apardyl/slam-robot/README.md

# slam-robot
Software and Hardware for Kinect v2 and Odroid XU4 based mobile platform.
