apardyl/slam-robot/Hardware/Mainboard/main.brd

## EAGLE design Hardware/Mainboard/main.brd (2016-07-07)

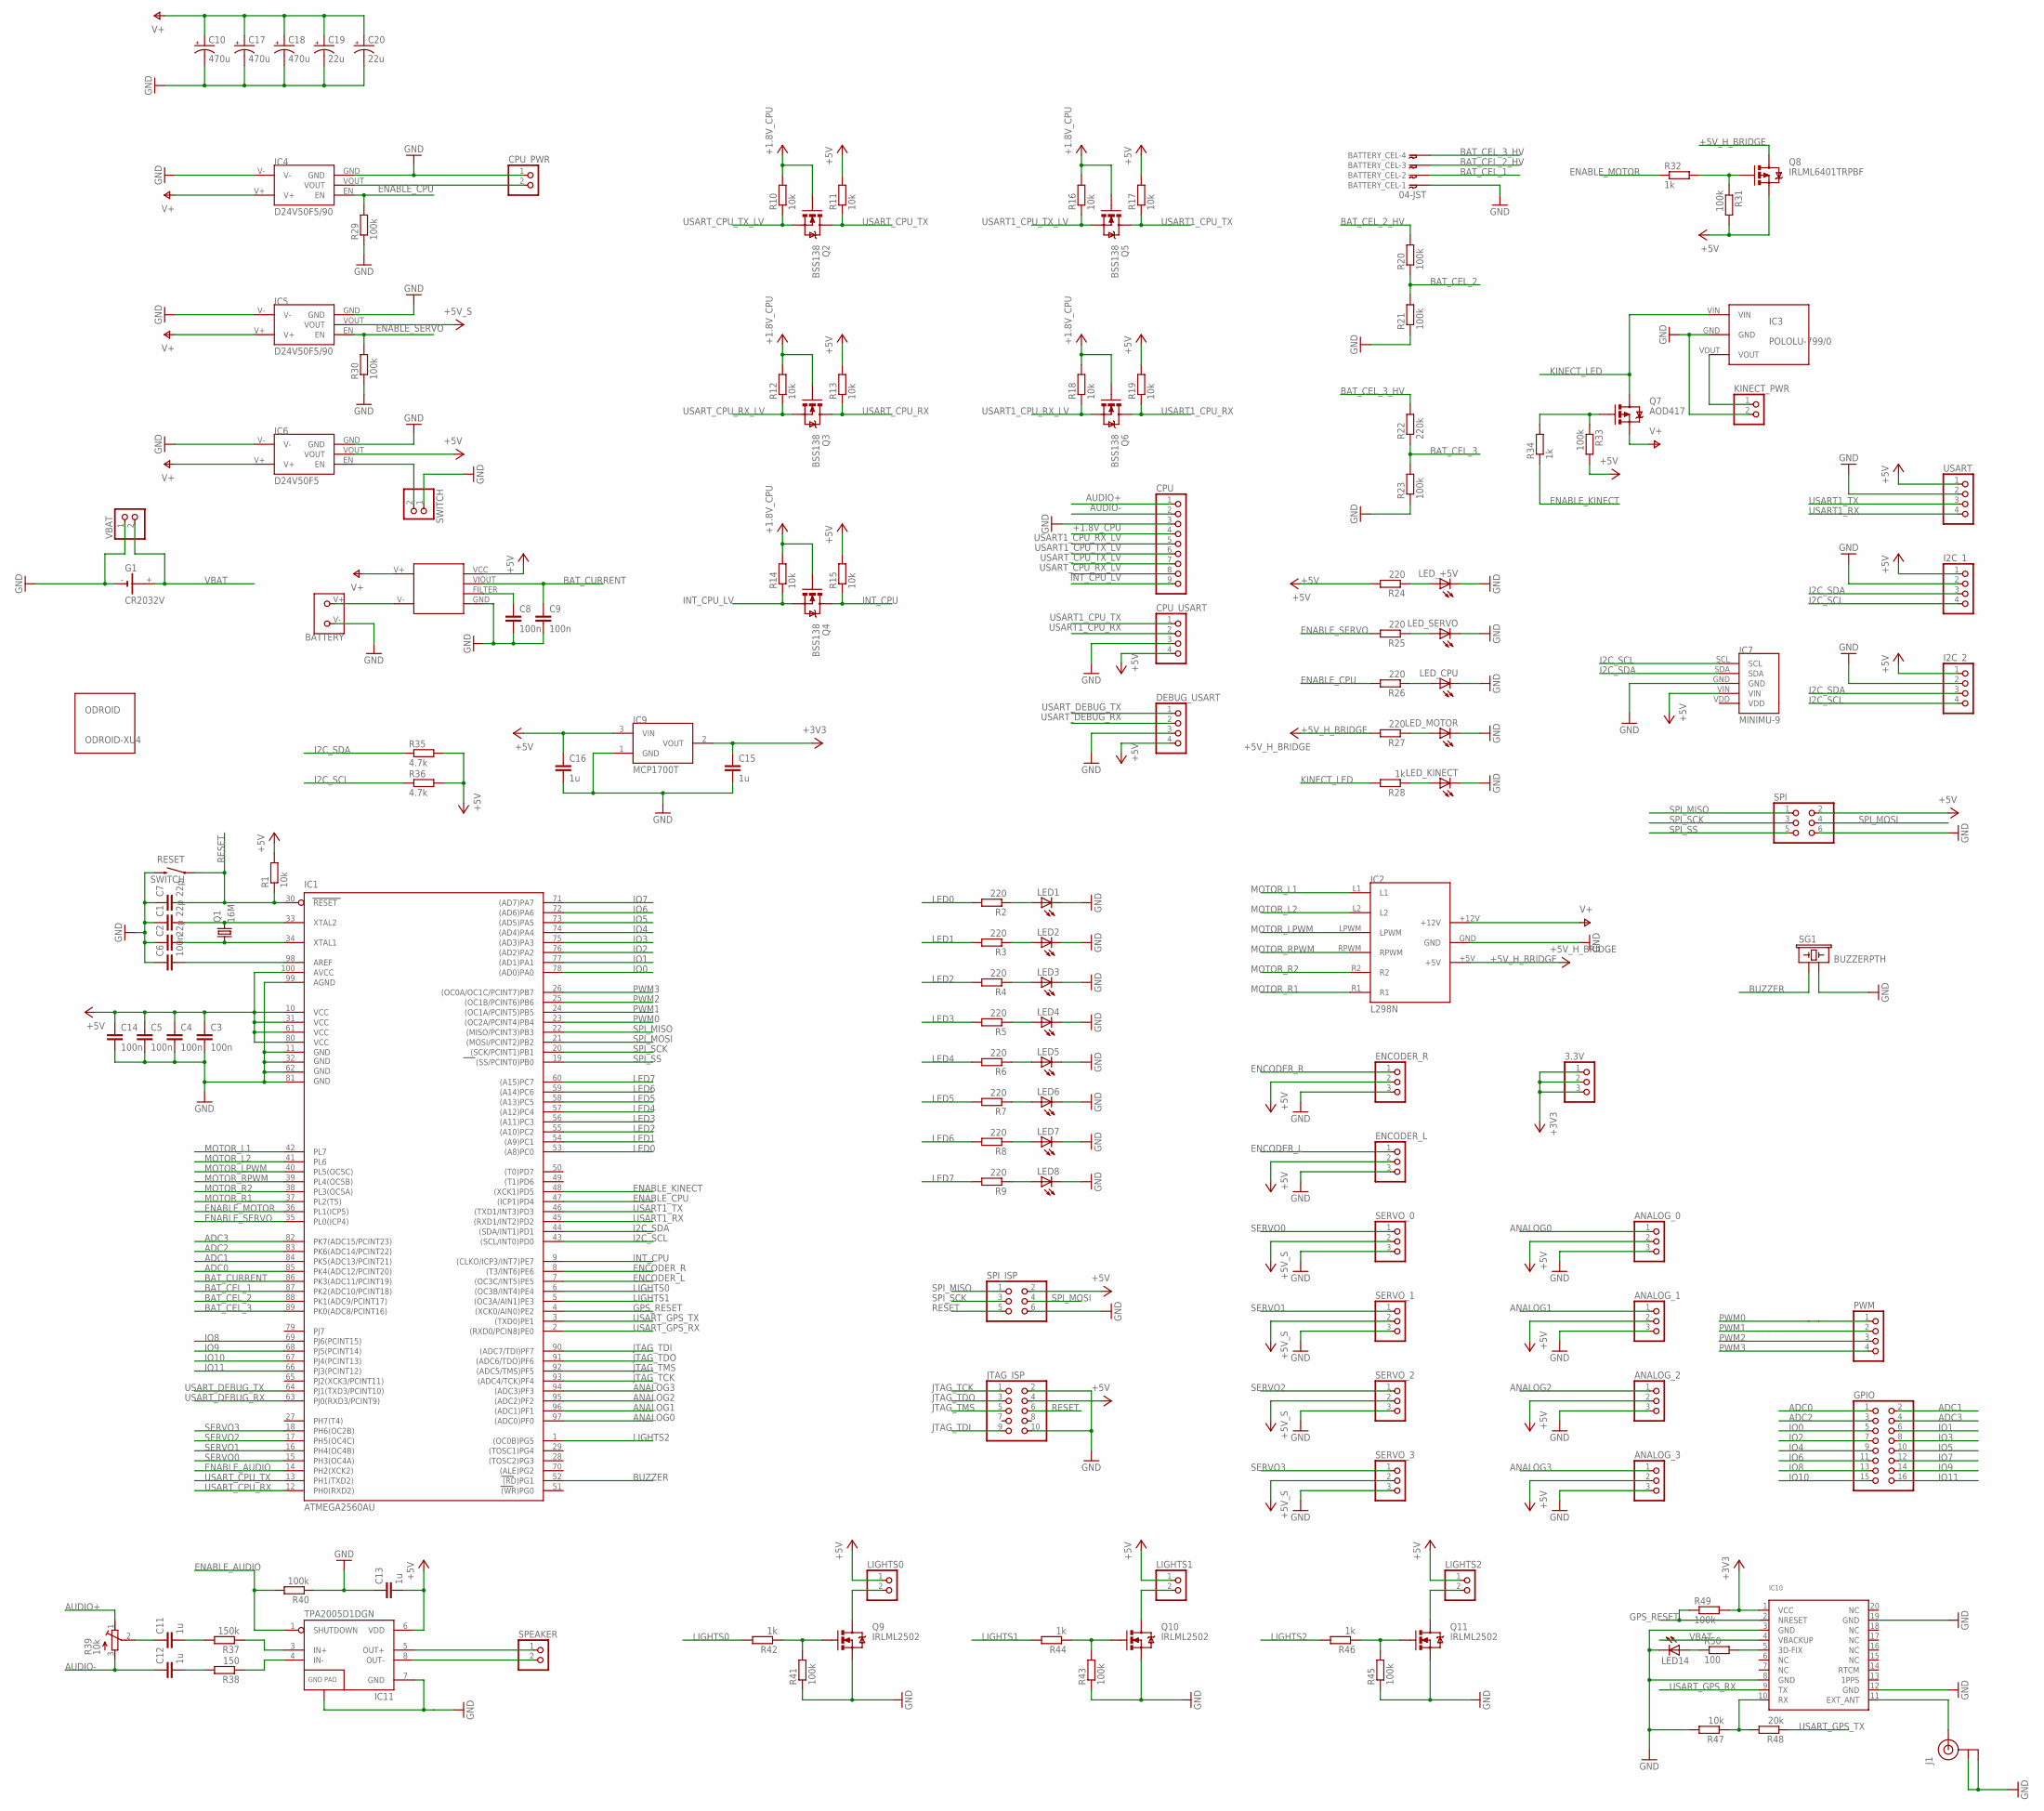
[picture p1: schematic main.sch]

Parts:
3.3V: PINHD-1X3; 1X03
ANALOG_0, ANALOG_1, ANALOG_2, ANALOG_3: PINHD-1X3; 1X03
BATTERY: XT60
BATTERY_CEL: 04-JST; B4B-XH
C1, C2, C7: 22p; C0805
C3, C4, C5, C6, C8, C9, C14: 100n; C0805
C10, C17, C18: 470u; PANASONIC_G
C11, C12, C13, C15, C16: 1u; C0805
C19, C20: 22u; EIA6032
CPU: PINHD-1X9; 1X09
CPU_PWR: PINHD-1X2; 1X02
CPU_USART: PINHD-1X4/90; 1X04/90
DEBUG_USART: PINHD-1X4/90; 1X04/90
ENCODER_L: PINHD-1X3; 1X03
ENCODER_R: PINHD-1X3; 1X03
G1: CR2032V
GPIO: PINHD-2X8; 2X08
I2C_1, I2C_2: PINHD-1X4; 1X04
IC1: ATMEGA2560AU; TQFP100
IC2: L298N; L298N-MOD
IC3: POLOLU-799/0; POLOLU799/0
IC4, IC5: D24V50F5/90; D24V50/90
IC6: D24V50F5; D24V50
IC7: MINIMU-9; MINIMU-9_V3
IC8: ACS715; ACS71X
IC9: MCP1700T; SOT23
IC10: GPS_FGPMMOPA6H; FGPMMOPA6H
IC11: TPA2005D1DGN; POWER-SOP8
J1: U.FL
JTAG_ISP: PINHD-2X5/90; 2X05/90
KINECT_PWR: PINHD-1X2; 1X02
LED1, LED2, LED3, LED4, LED5, LED6, LED7, LED8, LED14: LEDCHIPLED_0805; CHIPLED_0805
LED_+5V: LEDCHIPLED_0805; CHIPLED_0805
LED_CPU: LEDCHIPLED_0805; CHIPLED_0805
LED_KINECT: LEDCHIPLED_0805; CHIPLED_0805
LED_MOTOR: LEDCHIPLED_0805; CHIPLED_0805
LED_SERVO: LEDCHIPLED_0805; CHIPLED_0805
LIGHTS0, LIGHTS1, LIGHTS2: PINHD-1X2; 1X02
ODROID: ODROID-XU4
PWM: PINHD-1X4; 1X04
Q1: 16M; CRYSTAL-TXC-7A
Q2, Q3, Q4, Q5, Q6: BSS138; SOT23-3
Q7: AOD417; TO252
Q8: IRLML6401TRPBF; SOT23
Q9, Q10, Q11: IRLML2502; SOT23
R1, R10, R11, R12, R13, R14, R15, R16, R17, R18, R19, R47: 10k; R0805
R2, R3, R4, R5, R6, R7, R8, R9, R24, R25, R26, R27: 220; R0805
R20, R21, R23, R29, R30, R31, R33, R40, R41, R43, R45, R49: 100k; R0805
R22: 220k; R0805
R28, R32, R34, R42, R44, R46: 1k; R0805
R35, R36: 4.7k; R0805
R37: 150k; R0805
R38: 150; R0805
R39: 10k; RTRIM3314G
R48: 20k; R0805
R50: 100; R0805
RESET: SWITCH; TACTILE_SWITCH_TALL
SERVO_0, SERVO_1, SERVO_2, SERVO_3: PINHD-1X3; 1X03
SG1: BUZZERPTH; BUZZER-12MM
SPEAKER: PINHD-1X2; 1X02
SPI: PINHD-2X3; 2X03
SPI_ISP: PINHD-2X3; 2X03
SWITCH: PINHD-1X2/90; 1X02/90
USART: PINHD-1X4; 1X04
VBAT: PINHD-1X2; 1X02

Connections:
+1.8V_CPU: CPU.4, Q2.1 (G), Q3.1 (G), Q4.1 (G), Q5.1 (G), Q6.1 (G), R10.2, R12.2, R14.2, R16.2, R18.2
+3V3: 3.3V.1, 3.3V.2, 3.3V.3, C15.1, IC9.2 (VOUT), IC10.1 (VCC), R49.2
+5V: ANALOG_0.2, ANALOG_1.2, ANALOG_2.2, ANALOG_3.2, C3.1, C4.1, C5.1, C13.2, C14.1, C16.1, CPU_USART.4, DEBUG_USART.4, ENCODER_L.2, ENCODER_R.2, I2C_1.1, I2C_2.1, IC1.10 (VCC), IC1.31 (VCC1), IC1.61 (VCC2), IC1.80 (VCC3), IC1.100 (AVCC), IC6.VOUT, IC7.VIN, IC8.VCC, IC9.3 (VIN), IC11.6 (VDD), JTAG_ISP.4, LIGHTS0.1, LIGHTS1.1, LIGHTS2.1, Q8.2 (S), R1.2, R11.2, R13.2, R15.2, R17.2, R19.2, R24.2, R31.2, R33.2, R35.2, R36.2, SPI.2, SPI_ISP.2, USART.1
+5V_CPU: CPU_PWR.2, IC4.VOUT
+5V_H_BRIDGE: IC2.+5V, Q8.3 (D), R27.2
+5V_S: IC5.VOUT, SERVO_0.2, SERVO_1.2, SERVO_2.2, SERVO_3.2
ADC0: GPIO.1, IC1.85 (PK4(ADC12/PCINT20))
ADC1: GPIO.2, IC1.84 (PK5(ADC13/PCINT21))
ADC2: GPIO.3, IC1.83 (PK6(ADC14/PCINT22))
ADC3: GPIO.4, IC1.82 (PK7(ADC15/PCINT23))
ANALOG0: ANALOG_0.1, IC1.97 ((ADC0)PF0)
ANALOG1: ANALOG_1.1, IC1.96 ((ADC1)PF1)
ANALOG2: ANALOG_2.1, IC1.95 ((ADC2)PF2)
ANALOG3: ANALOG_3.1, IC1.94 ((ADC3)PF3)
AUDIO+: CPU.1, R39.1 (E)
AUDIO-: C12.1, CPU.2, R39.3 (A)
BAT_CEL_1: BATTERY_CEL.P$2, IC1.87 (PK2(ADC10/PCINT18))
BAT_CEL_2: IC1.88 (PK1(ADC9/PCINT17)), R20.1, R21.2
BAT_CEL_2_HV: BATTERY_CEL.P$3, R20.2
BAT_CEL_3: IC1.89 (PK0(ADC8/PCINT16)), R22.1, R23.2
BAT_CEL_3_HV: BATTERY_CEL.P$4, R22.2
BAT_CURRENT: C9.1, IC1.86 (PK3(ADC11/PCINT19)), IC8.VIOUT
BUZZER: IC1.52 ((RD)PG1), SG1.+ (1)
ENABLE: IC6.EN, SWITCH.2
ENABLE_AUDIO: IC1.14 (PH2(XCK2)), IC11.1 (SHUTDOWN), R40.2
ENABLE_CPU: IC1.47 ((ICP1)PD4), IC4.EN, R26.2, R29.2
ENABLE_KINECT: IC1.48 ((XCK1)PD5), R34.1
ENABLE_MOTOR: IC1.36 (PL1(ICP5)), R32.1
ENABLE_SERVO: IC1.35 (PL0(ICP4)), IC5.EN, R25.2, R30.2
ENCODER_L: ENCODER_L.1, IC1.7 ((OC3C/INT5)PE5)
ENCODER_R: ENCODER_R.1, IC1.8 ((T3/INT6)PE6)
GND: ANALOG_0.3, ANALOG_1.3, ANALOG_2.3, ANALOG_3.3, BATTERY.V-, BATTERY_CEL.P$1, C1.1, C2.1, C3.2, C4.2, C5.2, C6.1, C7.1, C8.2, C9.2, C10.-, C13.1, C14.2, C15.2, C16.2, C17.-, C18.-, C19.P$2 (-), C20.P$2 (-), CPU.3, CPU_PWR.1, CPU_USART.3, DEBUG_USART.3, ENCODER_L.3, ENCODER_R.3, G1.-, I2C_1.2, I2C_2.2, IC1.11 (GND), IC1.32 (GND1), IC1.62 (GND2), IC1.81 (GND3), IC1.99 (AGND), IC2.GND, IC3.GND, IC4.GND, IC4.V-, IC5.GND, IC5.V-, IC6.GND, IC6.V-, IC7.GND, IC8.GND, IC9.1 (GND), IC10.3 (GND), IC10.8 (GND), IC10.12 (GND), IC10.19 (GND), IC11.7 (GND), IC11.9 (GND), J1.P$1 (GND), J1.P$2 (GND), JTAG_ISP.2, JTAG_ISP.10, KINECT_PWR.2, LED1.C, LED2.C, LED3.C, LED4.C, LED5.C, LED6.C, LED7.C, LED8.C, LED14.C, LED_+5V.C, LED_CPU.C, LED_KINECT.C, LED_MOTOR.C, LED_SERVO.C, Q9.2 (S), Q10.2 (S), Q11.2 (S), R21.1, R23.1, R29.1, R30.1, R40.1, R41.1, R43.1, R45.1, R47.2, RESET.B2 (2), SERVO_0.3, SERVO_1.3, SERVO_2.3, SERVO_3.3, SG1.- (2), SPI.6, SPI_ISP.6, SWITCH.1, USART.2, VBAT.1
GPS_RESET: IC1.4 ((XCK0/AIN0)PE2), IC10.2 (NRESET), R49.1
I2C_SCL: I2C_1.4, I2C_2.4, IC1.43 ((SCL/INT0)PD0), IC7.SCL, R36.1
I2C_SDA: I2C_1.3, I2C_2.3, IC1.44 ((SDA/INT1)PD1), IC7.SDA, R35.1
INT_CPU: IC1.9 ((CLKO/ICP3/INT7)PE7), Q4.3 (D), R15.1
INT_CPU_LV: CPU.9, Q4.2 (S), R14.1
IO0: GPIO.5, IC1.78 ((AD0)PA0)
IO1: GPIO.6, IC1.77 ((AD1)PA1)
IO2: GPIO.7, IC1.76 ((AD2)PA2)
IO3: GPIO.8, IC1.75 ((AD3)PA3)
IO4: GPIO.9, IC1.74 ((AD4)PA4)
IO5: GPIO.10, IC1.73 ((AD5)PA5)
IO6: GPIO.11, IC1.72 ((AD6)PA6)
IO7: GPIO.12, IC1.71 ((AD7)PA7)
IO8: GPIO.13, IC1.69 (PJ6(PCINT15))
IO9: GPIO.14, IC1.68 (PJ5(PCINT14))
IO10: GPIO.15, IC1.67 (PJ4(PCINT13))
IO11: GPIO.16, IC1.66 (PJ3(PCINT12))
JTAG_TCK: IC1.93 ((ADC4/TCK)PF4), JTAG_ISP.1
JTAG_TDI: IC1.90 ((ADC7/TDI)PF7), JTAG_ISP.9
JTAG_TDO: IC1.91 ((ADC6/TDO)PF6), JTAG_ISP.3
JTAG_TMS: IC1.92 ((ADC5/TMS)PF5), JTAG_ISP.5
KINECT_LED: IC3.VIN, Q7.3 (D), R28.2
LED0: IC1.53 ((A8)PC0), R2.2
LED1: IC1.54 ((A9)PC1), R3.2
LED2: IC1.55 ((A10)PC2), R4.2
LED3: IC1.56 ((A11)PC3), R5.2
LED4: IC1.57 ((A12)PC4), R6.2
LED5: IC1.58 ((A13)PC5), R7.2
LED6: IC1.59 ((A14)PC6), R8.2
LED7: IC1.60 ((A15)PC7), R9.2
LIGHTS0: IC1.6 ((OC3B/INT4)PE4), R42.2
LIGHTS1: IC1.5 ((OC3A/AIN1)PE3), R44.2
LIGHTS2: IC1.1 ((OC0B)PG5), R46.2
MOTOR_L1: IC1.42 (PL7), IC2.L1
MOTOR_L2: IC1.41 (PL6), IC2.L2
MOTOR_LPWM: IC1.40 (PL5(OC5C)), IC2.LPWM
MOTOR_R1: IC1.37 (PL2(T5)), IC2.R1
MOTOR_R2: IC1.38 (PL3(OC5A)), IC2.R2
MOTOR_RPWM: IC1.39 (PL4(OC5B)), IC2.RPWM
unnamed: C1.2, IC1.33 (XTAL2), Q1.P$2 (2)
unnamed: C2.2, IC1.34 (XTAL1), Q1.P$1 (1)
unnamed: C6.2, IC1.98 (AREF)
unnamed: LED1.A, R2.1
unnamed: LED2.A, R3.1
unnamed: LED3.A, R4.1
unnamed: LED4.A, R5.1
unnamed: LED5.A, R6.1
unnamed: LED6.A, R7.1
unnamed: LED7.A, R8.1
unnamed: LED8.A, R9.1
unnamed: LED_+5V.A, R24.1
unnamed: BATTERY.V+, IC8.V-
unnamed: Q8.1 (G), R31.1, R32.2
unnamed: IC3.VOUT, KINECT_PWR.1
unnamed: LED_SERVO.A, R25.1
unnamed: C8.1, IC8.FILTER
unnamed: LED_CPU.A, R26.1
unnamed: LED_MOTOR.A, R27.1
unnamed: LED_KINECT.A, R28.1
unnamed: Q7.1 (G), R33.1, R34.2
unnamed: IC11.3 (IN+), R37.1
unnamed: IC11.4 (IN-), R38.1
unnamed: C11.2, R37.2
unnamed: C12.2, R38.2
unnamed: IC11.5 (OUT+), SPEAKER.1
unnamed: C11.1, R39.2 (S)
unnamed: IC11.8 (OUT-), SPEAKER.2
unnamed: LIGHTS0.2, Q9.3 (D)
unnamed: Q9.1 (G), R41.2, R42.1
unnamed: LIGHTS1.2, Q10.3 (D)
unnamed: Q10.1 (G), R43.2, R44.1
unnamed: LIGHTS2.2, Q11.3 (D)
unnamed: Q11.1 (G), R45.2, R46.1
unnamed: IC10.10 (RX), R47.1, R48.2
unnamed: IC10.5 (3D-FIX), R50.2
unnamed: LED14.A, R50.1
unnamed: IC10.11 (EXT_ANT), J1.P$3 (SIGNAL)
PWM0: IC1.23 ((OC2A/PCINT4)PB4), PWM.1
PWM1: IC1.24 ((OC1A/PCINT5)PB5), PWM.2
PWM2: IC1.25 ((OC1B/PCINT6)PB6), PWM.3
PWM3: IC1.26 ((OC0A/OC1C/PCINT7)PB7), PWM.4
RESET: C7.2, IC1.30 (RESET), JTAG_ISP.6, R1.1, RESET.A2 (1), SPI_ISP.5
SERVO0: IC1.15 (PH3(OC4A)), SERVO_0.1
SERVO1: IC1.16 (PH4(OC4B)), SERVO_1.1
SERVO2: IC1.17 (PH5(OC4C)), SERVO_2.1
SERVO3: IC1.18 (PH6(OC2B)), SERVO_3.1
SPI_MISO: IC1.22 ((MISO/PCINT3)PB3), SPI.1, SPI_ISP.1
SPI_MOSI: IC1.21 ((MOSI/PCINT2)PB2), SPI.4, SPI_ISP.4
SPI_SCK: IC1.20 ((SCK/PCINT1)PB1), SPI.3, SPI_ISP.3
SPI_SS: IC1.19 ((SS/PCINT0)PB0), SPI.5
USART1_CPU_RX: CPU_USART.2, Q6.3 (D), R19.1
USART1_CPU_RX_LV: CPU.5, Q6.2 (S), R18.1
USART1_CPU_TX: CPU_USART.1, Q5.3 (D), R17.1
USART1_CPU_TX_LV: CPU.6, Q5.2 (S), R16.1
USART1_RX: IC1.45 ((RXD1/INT2)PD2), USART.4
USART1_TX: IC1.46 ((TXD1/INT3)PD3), USART.3
USART_CPU_RX: IC1.12 (PH0(RXD2)), Q3.3 (D), R13.1
USART_CPU_RX_LV: CPU.8, Q3.2 (S), R12.1
USART_CPU_TX: IC1.13 (PH1(TXD2)), Q2.3 (D), R11.1
USART_CPU_TX_LV: CPU.7, Q2.2 (S), R10.1
USART_DEBUG_RX: DEBUG_USART.2, IC1.63 (PJ0(RXD3/PCINT9))
USART_DEBUG_TX: DEBUG_USART.1, IC1.64 (PJ1(TXD3/PCINT10))
USART_GPS_RX: IC1.2 ((RXD0/PCIN8)PE0), IC10.9 (TX)
USART_GPS_TX: IC1.3 ((TXD0)PE1), R48.1
V+: C10.+, C17.+, C18.+, C19.P$1 (+), C20.P$1 (+), IC2.+12V, IC4.V+, IC5.V+, IC6.V+, IC8.V+, Q7.2 (S)
VBAT: G1.+, IC10.4 (VBACKUP), VBAT.2

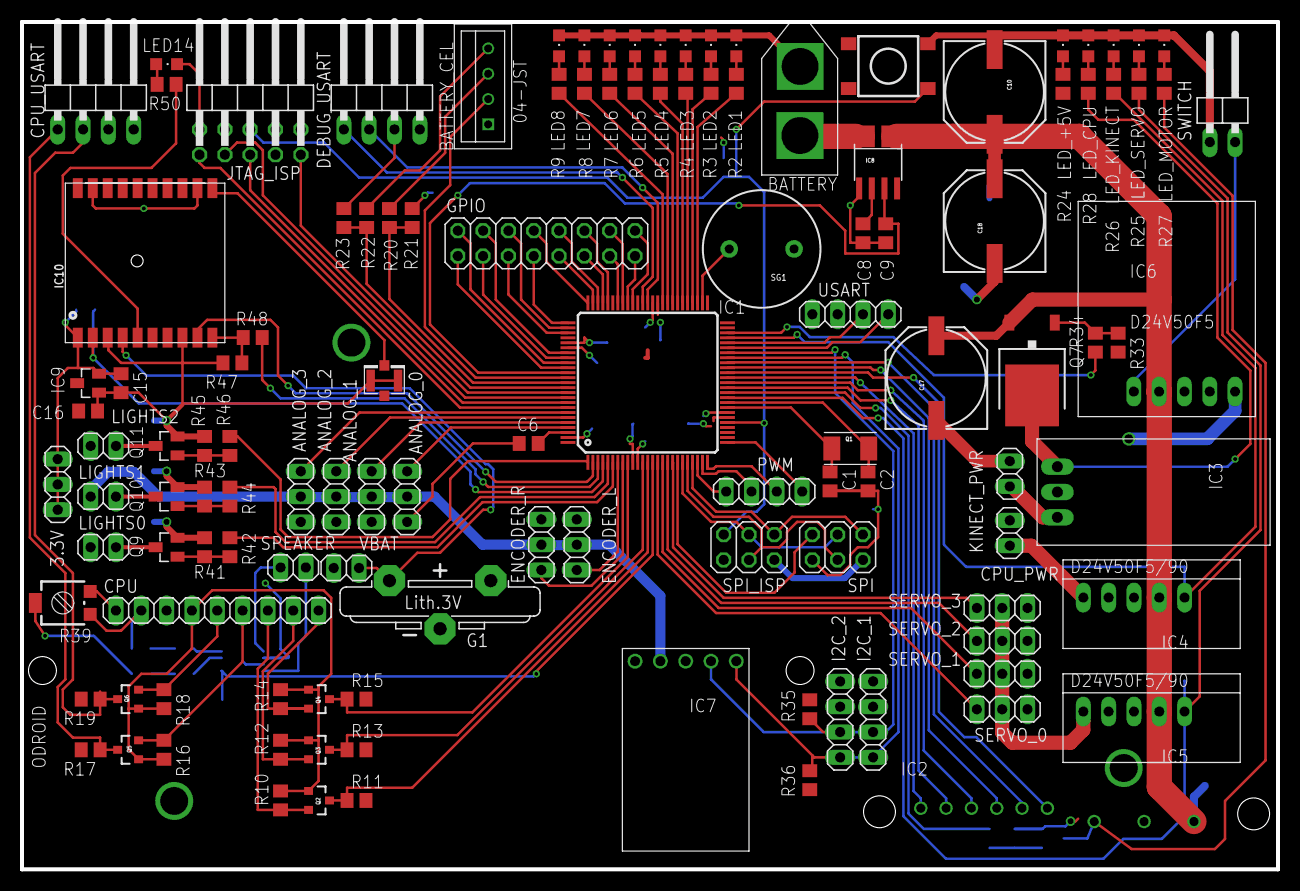
[picture p2: board main.brd from above]

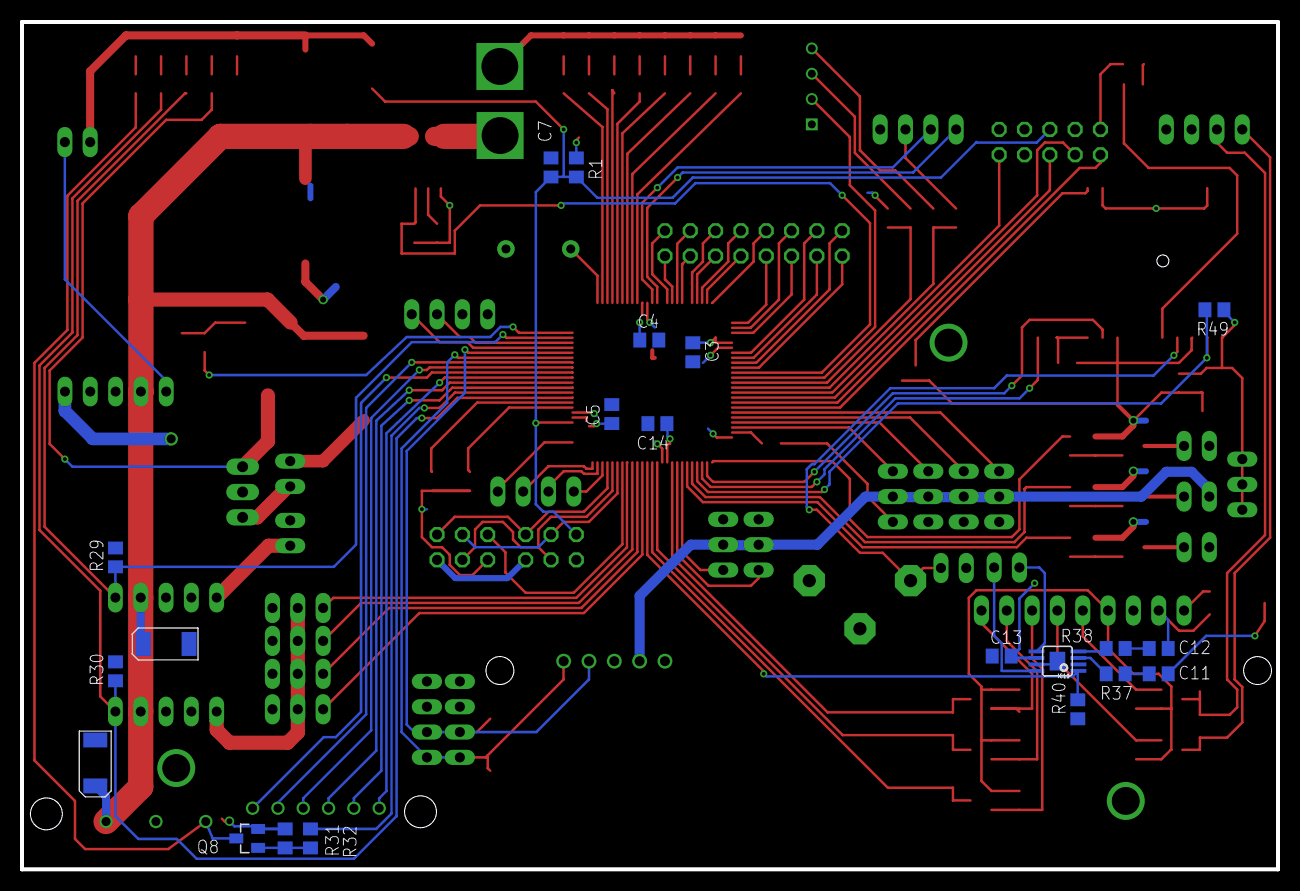
[picture p3: board main.brd from below]

Board: 2 copper layers, 126.0 x 85.0 mm, 143 parts (21 on the bottom side), 138 nets.
