apardyl/slam-robot/Firmware/Firmware/ADC.cpp

#include "ADC.h"
#include <avr/io.h>
#include <avr/interrupt.h>
	
Adc adc;
	
void Adc::worker() {
	if(isBusy) return;
	ADMUX = (1<<REFS0);
	ADCSRA = (1<<ADEN) | (1<<ADSC) | (1<<ADIE) | (1<<ADPS2) | (1<<ADPS1);
	isBusy = true;
	current = ADC0;
}

uint16_t Adc::read(ports port) {
	return reading[port];
}

void Adc::isr() {
	reading[current] = ADC;
	if(current == ADC15) {
		ADCSRA = 0x00;
		isBusy = false;
		return;
	}
	if(current == ADC3) current = ADC8;
	else current = (ports)(((uint8_t)current) + 1);
	
	ADMUX = (1<<REFS0) | (current & 0b111);
	ADCSRB = current & 0b1000;
	ADCSRA = (1<<ADEN) | (1<<ADSC) | (1<<ADIE) | (1<<ADPS2) | (1<<ADPS1);
}
	

ISR(ADC_vect) {
	adc.isr();
}
