apardyl/slam-robot/Firmware/Firmware/power.h

#ifndef POWER_H_
#define POWER_H_

void initPower();
void enableCPU(bool enable);
void enableKinect(bool enable);
void enableServos(bool enable);
void enableMotors(bool enable);
void enableAudio(bool enable);


#endif /* POWER_H_ */
