apardyl/slam-robot/Firmware/Firmware/time.cpp

#include "time.h"
#include <avr/io.h>
#include <avr/interrupt.h>

volatile uint32_t milis = 0;

void initTime() {
	TCCR0A = (1<<WGM01);
	OCR0A = 250;
	TCCR0B = (1<<CS00) | (1<<CS01);
	TIMSK0 = (1<<OCIE0A);
}

ISR(TIMER0_COMPA_vect) {
	milis++;
}
