apardyl/slam-robot/(commit log)

2016-07-07 Add mainboard design
    [main.brd, main.sch]
2016-08-22 Add interrupt-driven I2C
2016-09-03 Fix TWI multibyte operations, Add IMU init
    [IMU.cpp, IMU.h, TWIStateMachine.cpp, TWIStateMachine.h, main.cpp]
2016-09-03 Add IMU read
2016-09-04 Add sensor data transmission, Add time counter, Fix FIFO interrupt bug
    [FIFO.cpp, FIFO.h, IMU.cpp, IMU.h, main.cpp, time.cpp, usart.cpp]
2016-09-06 Add ADC, minor refactor
2016-10-01 Fix i2c blocking on hardware malfunction
    [i2c.cpp, i2c.h, main.cpp]
2017-12-27 Remove created-on-by headers, fix file endings
    [ADC.cpp, ADC.h, FIFO.cpp, FIFO.h, IMU.cpp, IMU.h, encoder.cpp]
2017-12-27 Increase max allowed motor speed
2017-12-27 Add URM37 sonar support
2017-12-27 Change motor control style
